schlae/sws600-12/pcb1.jpg

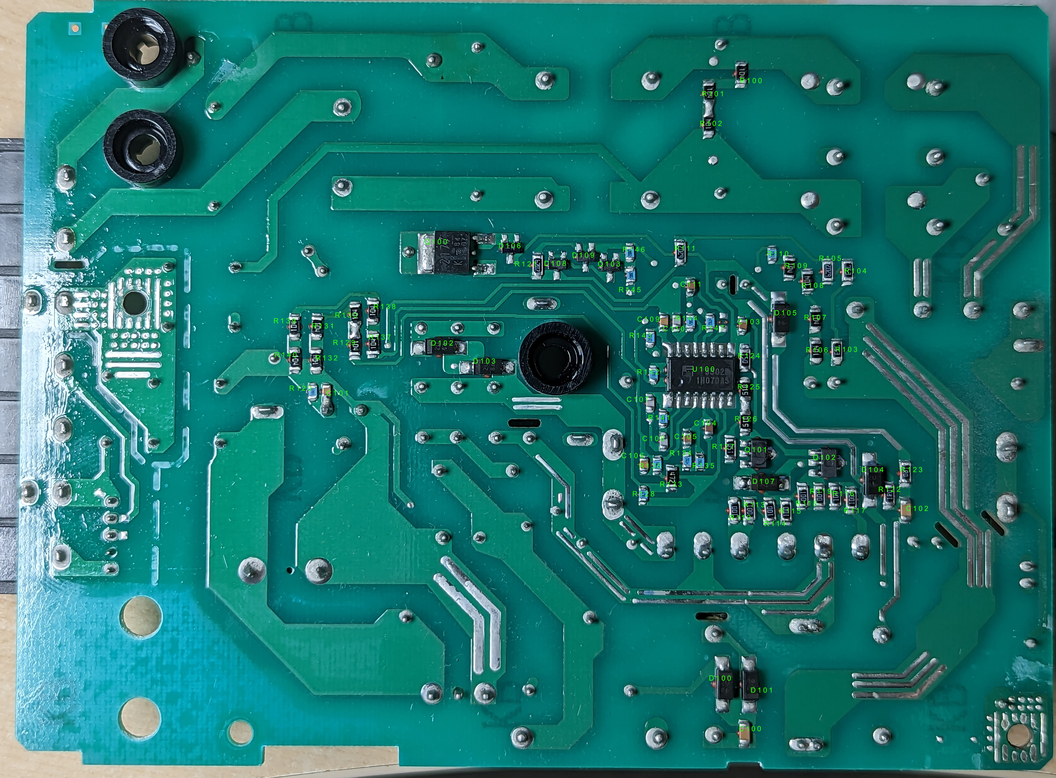
pcb1.jpg
