schlae/sws600-12/pcb2.jpg

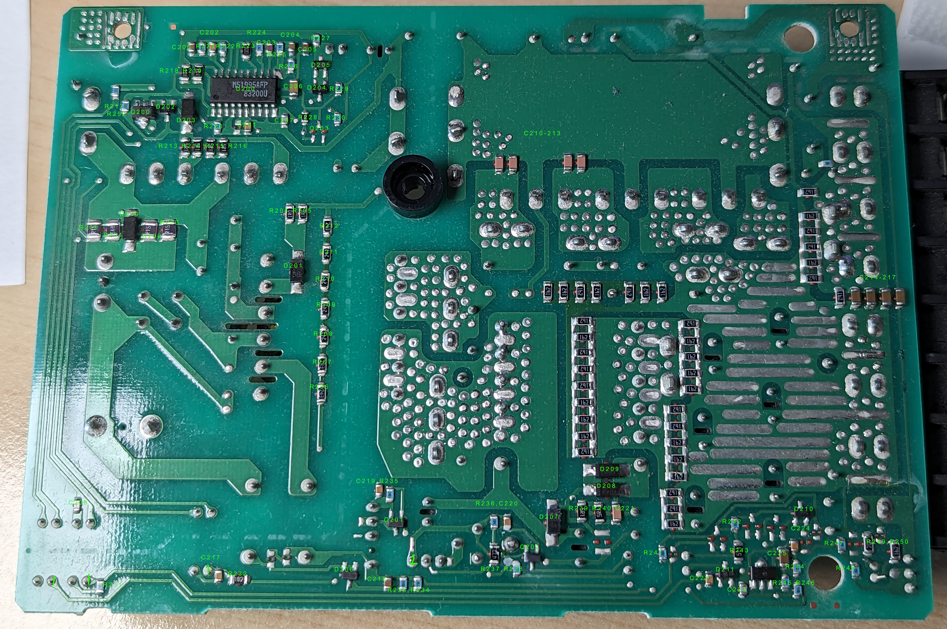
pcb2.jpg
