schlae/sws600-12/README.md

# SWS600-12

This repository contains a reverse engineered schematic for the TDK SWS600-12 power supply. Use at your own risk.

## License
Creative Commons BY-SA 4.0 International.
