schlae/sws600-12/SWS600-12.pdf

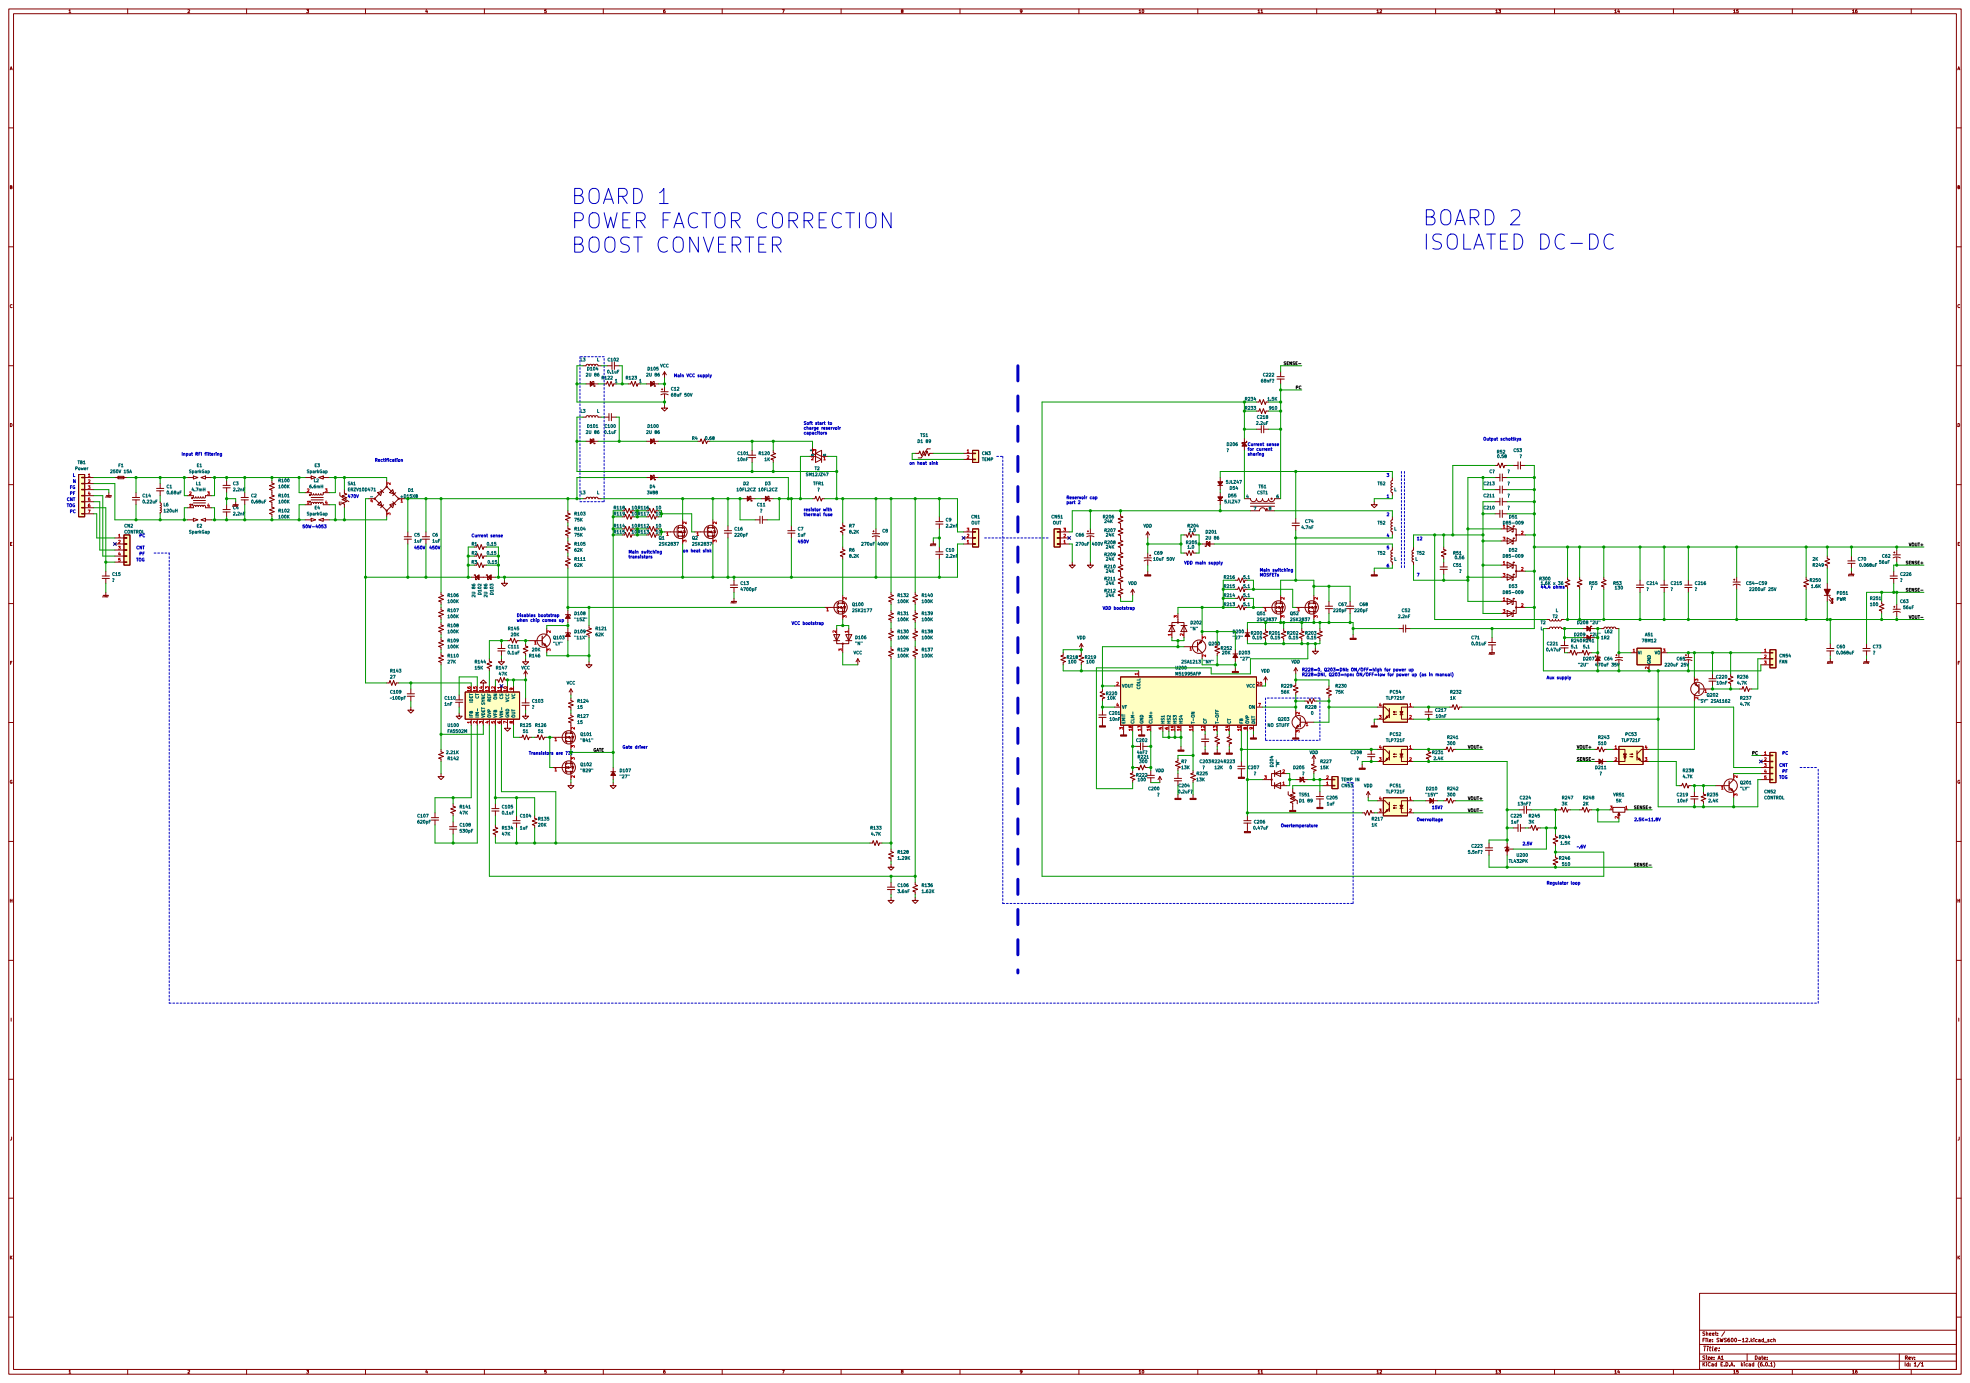
[picture p3: page 1]

Main switching MOSFETs Current sense

Input RFI filtering PC

when chip comes up Rectification

VDD
R228=0, Q203=DNI: ON/OFF=high for power up
R228=DNI, Q203=npn: ON/OFF=low for power up (as in manual)

1 FB 10 T-ON 11 CF 12 T-OFF 13 CT 14 HS3 15 HS4 16 GND 17 CLM- 18 CLM+ 19 VOUT

1 VCC 10 CS 11 ON 12 REF 13 SYNC 14 CT 15 IDET 16 IIN- 2 VDET
