schlae/sws600-12/SWS600-12.kicad_sch

## KiCad design SWS600-12.kicad_sch (2023-04-27)

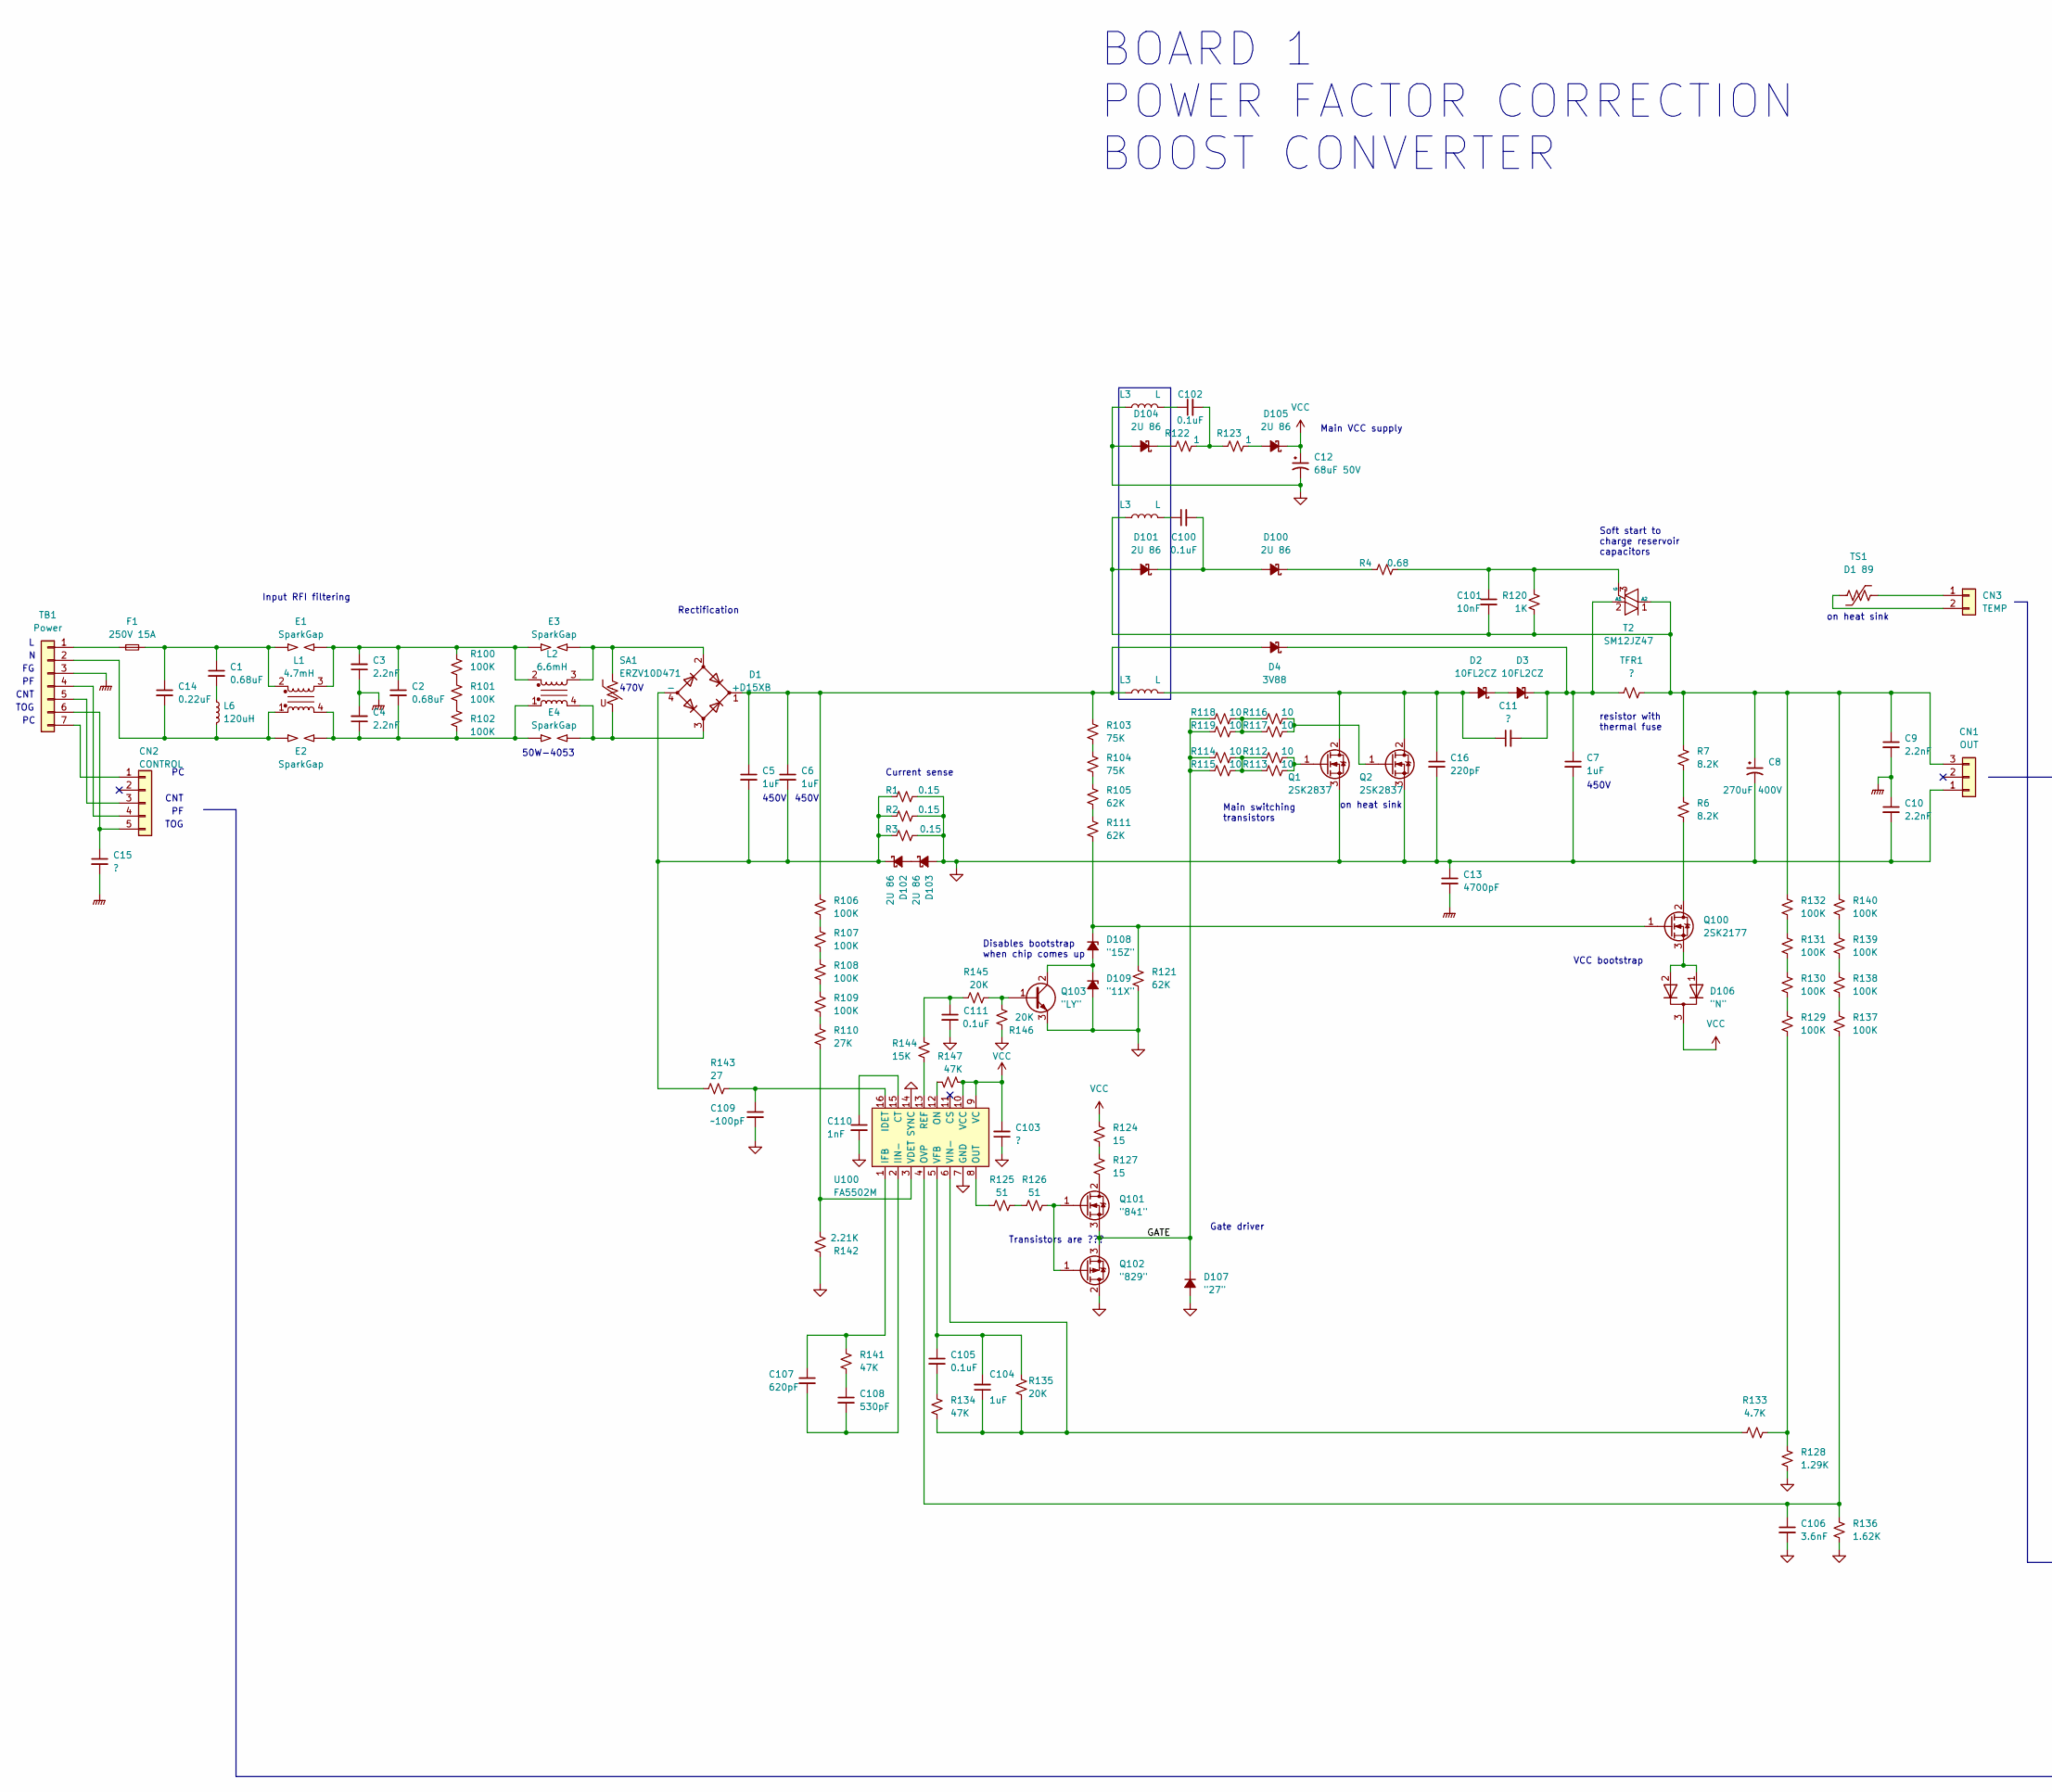
[picture p4: schematic SWS600-12.kicad_sch, part in row 1, column 1]

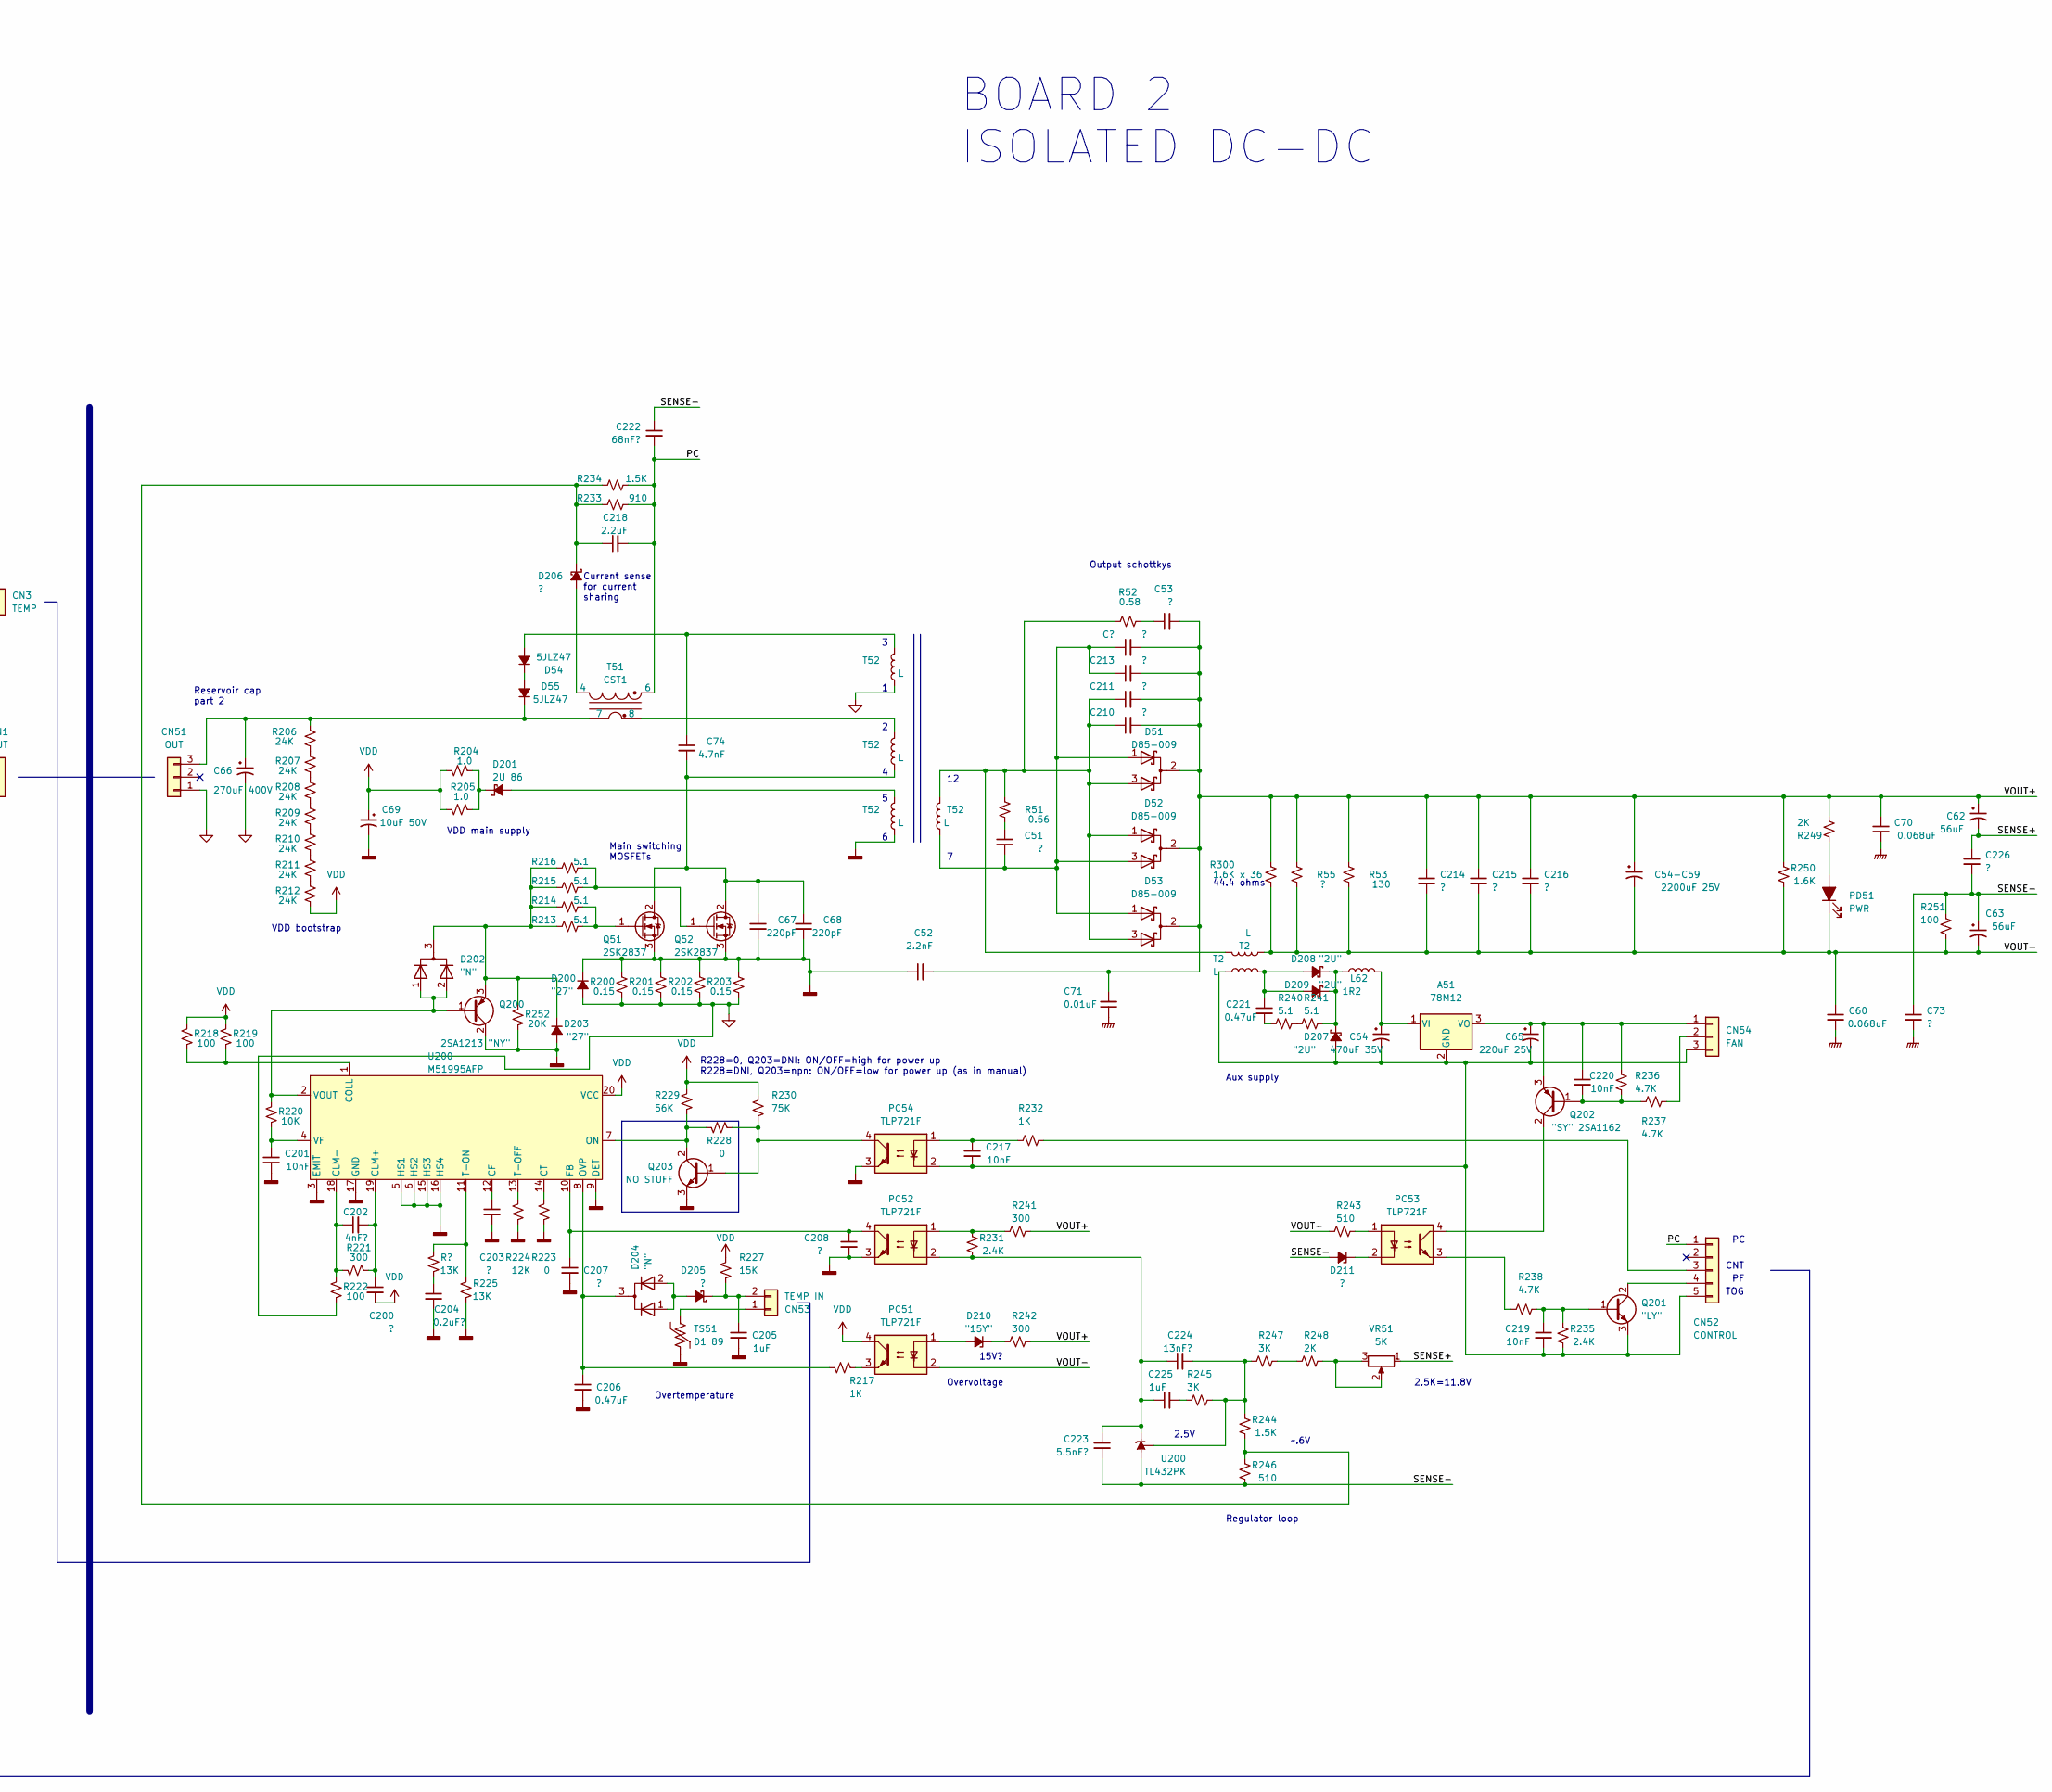
[picture p5: schematic SWS600-12.kicad_sch, part in row 1, column 2]

Parts:
A51: 78M12; TO-220-3_Vertical
C1, C2: 0.68uF
C3, C4, C9, C10, C52: 2.2nF
C5, C6, C7, C104, C205, C225: 1uF
C8, C66: 270uF 400V
C11, C15, C51, C53, C73, C103, C200, C203, C207, C208, C210, C211, C213, C214, C215, C216, C226: ?
C12: 68uF 50V
C13: 4700pF
C14: 0.22uF
C16, C67, C68: 220pF
C54-C59: 2200uF 25V
C60, C70: 0.068uF
C62, C63: 56uF
C64: 470uF 35V
C65: 220uF 25V
C69: 10uF 50V
C71: 0.01uF
C74: 4.7nF
C100, C102, C105, C111: 0.1uF
C101, C201, C217, C219, C220: 10nF
C106: 3.6nF
C107: 620pF
C108: 530pF
C109: ~100pF
C110: 1nF
C202: 4nF?
C204: 0.2uF?
C206, C221: 0.47uF
C218: 2.2uF
C222: 68nF?
C223: 5.5nF?
C224: 13nF?
CN1, CN51: OUT
CN2, CN52: CONTROL
CN3: TEMP
CN53: TEMP IN
CN54: FAN
D1: D15XB
D2, D3: 10FL2CZ
D4: 3V88
D51, D52, D53: D85-009
D54, D55: 5JLZ47
D100, D101, D102, D103, D104, D105, D201: 2U 86
D106, D202, D204: "N"
D107, D200, D203: "27"
D108: "15Z"
D109: "11X"
D205, D206, D211: ?
D207, D208, D209: "2U"
D210: "15Y"
E1, E2, E3, E4: SparkGap
F1: 250V 15A
L1: 4.7mH
L2: 6.6mH
L3: L
L6: 120uH
L62: 1R2
PC51, PC52, PC53, PC54: TLP721F; DIP-4_W7.62mm
PD51: PWR
Q1, Q2, Q51, Q52: 2SK2837
Q100: 2SK2177
Q101: "841"
Q102: "829"
Q103, Q201: "LY"
Q200: 2SA1213 "NY"
Q202: "SY" 2SA1162
Q203: NO STUFF
R1, R2, R3, R200, R201, R202, R203: 0.15
R4: 0.68
R6, R7: 8.2K
R51: 0.56
R52: 0.58
R53: 130
R55: ?
R100, R101, R102, R106, R107, R108, R109, R129, R130, R131, R132, R137, R138, R139, R140: 100K
R103, R104, R230: 75K
R105, R111, R121: 62K
R110: 27K
R112, R113, R114, R115, R116, R117, R118, R119: 10
R120, R217, R232: 1K
R122, R123: 1
R124, R127: 15
R125, R126: 51
R128: 1.29K
R133, R236, R237, R238: 4.7K
R134, R141, R147: 47K
R135, R145, R146, R252: 20K
R136: 1.62K
R142: 2.21K
R143: 27
R144, R227: 15K
R204, R205: 1.0
R206, R207, R208, R209, R210, R211, R212: 24K
R213, R214, R215, R216, R240, R241: 5.1
R218, R219, R222, R251: 100
R220: 10K
R221, R242: 300
R223, R228: 0
R224: 12K
R225: 13K
R229: 56K
R231, R235: 2.4K
R233: 910
R234, R244: 1.5K
R243, R246: 510
R245, R247: 3K
R248, R249: 2K
R250: 1.6K
R300: 1.6K x 36
SA1: ERZV10D471
T2, T52: L
T51: CST1; Transformer_Coilcraft_CST1
TB1: Power
TFR1: ?
TS1, TS51: D1 89
U100: FA5502M
U200: M51995AFP
VR51: 5K

Connections:
GATE: D107.1 (K), Q101.3 (S), Q102.3 (S), R114.1, R115.1, R118.1, R119.1
unnamed: A51.1 (VI), C64.1, L62.1
unnamed: A51.2 (GND), C64.2, C65.2, C217.2, C219.2, CN52.5, CN54.3, D207.2 (A), PC54.2, Q201.3 (E), R235.1, T2.1
unnamed: A51.3 (VO), C65.1, C220.1, CN54.1, Q202.3 (E), R236.1
unnamed: C1.1, C14.1, E1.1, F1.2, L1.2
unnamed: C1.2, L6.1
unnamed: C2.1, C3.2, E1.2, E3.1, L1.3, L2.2, R100.1
unnamed: C2.2, C4.1, E2.2, E4.1, L1.4, L2.1, R102.2
unnamed: C3.1, C4.2
unnamed: C5.1, C6.1, D1.1 (+), D4.2 (A), L3.1, R103.1, R106.1
unnamed: C5.2, C6.2, D1.4 (-), D102.1 (K), R1.2, R2.2, R3.2, R143.2
unnamed: C9.2, C10.1
unnamed: C7.2, C8.2, C10.2, C13.1, C16.2, CN1.1, D103.2 (A), Q1.3 (S), Q2.3 (S), R1.1, R2.1, R3.1
unnamed: C11.1, C16.1, D2.2 (A), L3.2, Q1.2 (D), Q2.2 (D)
unnamed: C7.1, C11.2, D3.1 (K), D4.1 (K), T2.2, TFR1.1
unnamed: C12.1, D105.1 (K)
unnamed: C12.2, D104.2 (A), L3.1
unnamed: C14.2, E2.1, L1.1, L6.2, TB1.2
unnamed: C15.1, CN2.5, TB1.6
unnamed: C51.1, R51.2
unnamed: C52.1, C67.2, C68.2, D200.1 (K), Q51.3 (S), Q52.3 (S), R200.1, R201.1, R202.1, R203.1
unnamed: C53.1, R52.2
unnamed: C66.1, CN51.3, D55.1 (K), R206.1, T51.7
unnamed: C67.1, C68.1, C74.2, Q51.2 (D), Q52.2 (D), T52.1
unnamed: C69.1, R204.2, R205.2
unnamed: C74.1, D54.2 (A), T52.2
unnamed: C100.1, L3.2
unnamed: C100.2, D100.2 (A), D101.1 (K)
unnamed: C101.1, R4.2, R120.2, T2.3 (G)
unnamed: C8.1, C9.1, C101.2, CN1.3, D101.2 (A), L3.1, R7.1, R120.1, R132.2, R140.2, T2.1, TFR1.2
unnamed: C102.1, L3.2
unnamed: C102.2, R122.2, R123.1
unnamed: C103.2, R147.2, U100.9 (VC), U100.10 (VCC)
unnamed: C104.1, R133.2, R134.2, R135.2, U100.6 (VIN-)
unnamed: C104.2, C105.1, R135.1, U100.5 (VFB)
unnamed: C105.2, R134.1
unnamed: C106.1, R136.1, R137.1, U100.4 (OVP)
unnamed: C107.1, R141.1, U100.1 (IFB)
unnamed: C107.2, C108.2, U100.2 (IIN-)
unnamed: C108.1, R141.2
unnamed: C109.1, R143.1, U100.16 (IDET)
unnamed: C110.1, U100.15 (CT)
unnamed: C111.1, R144.1, R145.1
unnamed: C200.1, C202.2, R221.2, U200.19 (CLM+)
unnamed: C201.1, R220.2, U200.4 (VF)
unnamed: C202.1, R221.1, R222.1, U200.18 (CLM-)
unnamed: C203.1, U200.12 (CF)
unnamed: C205.1, CN53.2, D205.1 (K), R227.1
unnamed: C206.1, D204.3 (A), R217.2, U200.8 (OVP)
unnamed: C207.1, C208.1, PC52.4, U200.10 (FB)
unnamed: C208.2, PC52.3
unnamed: C210.1, C211.1, D51.3 (K), D52.1 (K), D53.3 (K), R51.1, R52.1, T2.1, T52.2
unnamed: C51.2, C213.1, D51.1 (K), D52.3 (K), D53.1 (K), T52.1
unnamed: C217.1, PC54.1, R232.2
unnamed: C218.1, D206.1 (K), R233.1, R234.1, R244.1, R246.2
unnamed: C219.1, Q201.1 (B), R235.2, R238.1
unnamed: C220.2, Q202.1 (B), R236.2, R237.2
unnamed: C221.1, D208.2 (A), D209.2 (A), T2.2
unnamed: C221.2, R240.2
unnamed: C223.1, C224.1, C225.1, PC52.2, R231.1, U200.1 (K)
unnamed: C224.2, R244.2, R245.1, R247.2, U200.3 (REF)
unnamed: C225.2, R245.2
unnamed: CN2.1, TB1.7
unnamed: CN2.3, TB1.5
unnamed: CN2.4, TB1.4
unnamed: CN3.1, TS1.2
unnamed: CN3.2, TS1.1
unnamed: CN52.3, R232.1
unnamed: CN52.4, Q201.2 (C)
unnamed: CN53.1, TS51.1
unnamed: CN54.2, R237.1
unnamed: D1.2, E3.2, L2.3, SA1.1
unnamed: D1.3, E4.2, L2.4, SA1.2
unnamed: D2.1 (K), D3.2 (A)
unnamed: D54.1 (K), D55.2 (A)
unnamed: D100.1 (K), R4.1
unnamed: D102.2 (A), D103.1 (K)
unnamed: D104.1 (K), R122.1
unnamed: D105.2 (A), R123.2
unnamed: D106.1 (K), D106.2 (K), Q100.3 (S)
unnamed: D108.1 (K), Q100.1 (G), R111.2, R121.2
unnamed: D108.2 (A), D109.1 (K), Q103.2 (C)
unnamed: D109.2 (A), Q103.3 (E), R121.1
unnamed: D200.2 (A), R200.2, R201.2, R202.2, R203.2, R222.2
unnamed: D201.1 (K), R204.1, R205.1
unnamed: D201.2 (A), T52.2
unnamed: D202.1 (K), D202.2 (K), Q200.1 (B), R220.1, U200.2 (A)
unnamed: D202.3 (A), D203.1 (K), Q200.3 (E), R213.1, R214.1, R215.1, R216.1, R252.1
unnamed: D203.2 (A), Q200.2 (C), R252.2
unnamed: D204.1 (K), D204.2 (K), D205.2 (A)
unnamed: D206.2 (A), T51.4
unnamed: D207.1 (K), D208.1 (K), D209.1 (K), L62.2, R241.1
unnamed: D210.1 (K), R242.2
unnamed: D210.2 (A), PC51.1
unnamed: D211.1 (K), PC53.2
unnamed: F1.1, TB1.1
unnamed: PC51.3, R217.1
unnamed: PC52.1, R231.2, R241.2
unnamed: PC53.1, R243.1
unnamed: PC53.3, R238.2
unnamed: PC53.4, Q202.2 (C)
unnamed: PC54.4, Q203.1 (B), R228.2, R230.1
unnamed: PD51.2 (A), R249.2
unnamed: Q1.1 (G), R112.2, R113.2
unnamed: Q2.1 (G), R116.2, R117.2
unnamed: Q51.1 (G), R213.2, R214.2
unnamed: Q52.1 (G), R215.2, R216.2
unnamed: Q100.2 (D), R6.2
unnamed: Q101.1 (G), Q102.1 (G), R126.2
unnamed: Q101.2 (D), R127.1
unnamed: Q103.1 (B), R145.2, R146.2
unnamed: Q203.2 (C), R228.1, R229.1, U200.7 (ON)
unnamed: R6.1, R7.2
unnamed: R100.2, R101.1
unnamed: R101.2, R102.1
unnamed: R103.2, R104.1
unnamed: R104.2, R105.1
unnamed: R105.2, R111.1
unnamed: R106.2, R107.1
unnamed: R107.2, R108.1
unnamed: R108.2, R109.1
unnamed: R109.2, R110.1
unnamed: R110.2, R142.2, U100.3 (VDET)
unnamed: R112.1, R113.1, R114.2, R115.2
unnamed: R116.1, R117.1, R118.2, R119.2
unnamed: R124.1, R127.2
unnamed: R125.1, U100.8 (OUT)
unnamed: R125.2, R126.1
unnamed: R128.2, R129.1, R133.1
unnamed: R129.2, R130.1
unnamed: R130.2, R131.1
unnamed: R131.2, R132.1
unnamed: R137.2, R138.1
unnamed: R138.2, R139.1
unnamed: R139.2, R140.1
unnamed: R144.2, U100.13 (REF)
unnamed: R147.1, U100.12 (ON)
unnamed: R206.2, R207.1
unnamed: R207.2, R208.1
unnamed: R208.2, R209.1
unnamed: R209.2, R210.1
unnamed: R210.2, R211.1
unnamed: R211.2, R212.1
unnamed: R218.1, R219.1
unnamed: R218.2, R219.2, U200.1 (K)
unnamed: R223.1, U200.14 (CT)
unnamed: R224.1, U200.13 (T-OFF)
unnamed: R225.1, U200.11 (T-ON)
unnamed: R229.2, R230.2
unnamed: R240.1, R241.2
unnamed: R247.1, R248.2
unnamed: R248.1, VR51.2, VR51.3
unnamed: T51.8, T52.2
unnamed: U200.5 (HS1), U200.6 (HS2), U200.15 (HS3), U200.16 (HS4)
PC: C218.2, C222.2, CN52.1, R233.2, R234.2, T51.6
SENSE+: C62.2, C226.1, VR51.1
SENSE-: C63.1, C73.1, C222.1, C223.2, C226.2, D211.2 (A), R246.1, R251.1, U200.2 (A)
VOUT+: C52.2, C53.2, C54-C59.1, C62.1, C70.1, C71.2, C210.2, C211.2, C213.2, C214.1, C215.1, C216.1, D51.2 (A), D52.2 (A), D53.2 (A), R53.1, R55.1, R241.1, R242.1, R243.2, R249.1, R250.2, R300.1
VOUT-: C54-C59.2, C60.1, C63.2, C214.2, C215.2, C216.2, PC51.2, PD51.1 (K), R53.2, R55.2, R250.1, R251.2, R300.2, T2.2

Notes on the sheet:
Disables bootstrap when chip comes up
CNT
470V
Overvoltage
~.6V
Aux supply
44.4 ohms
Main switching MOSFETs
BOARD 2 ISOLATED DC-DC
resistor with thermal fuse
450V
2.5V
VDD main supply
Current sense for current sharing
Soft start to charge reservoir capacitors
VDD bootstrap
Input RFI filtering
Rectification
Main VCC supply
Reservoir cap part 2
TOG
Regulator loop
on heat sink
Output schottkys
Main switching transistors
VCC bootstrap
15V?
50W-4053
Overtemperature
Transistors are ???
BOARD 1 POWER FACTOR CORRECTION BOOST CONVERTER
Gate driver
2.5K=11.8V
Current sense
R228=0, Q203=DNI: ON/OFF=high for power up R228=DNI, Q203=npn: ON/OFF=low for power up (as in manual)
